W3PM/A-Simple-WSPR-Transmitter-Receiver/README.md

# A-Simple-WSPR-Transmitter-Receiver
SoftRock Lite II receiver and Si5351A transmitter

An inexpensive project based around a partially built $21 SoftRock Lite II receiver and an $8 Si5351A module. The transceiver provides single band operation between 630 and 10 meters.
